jankae/Teststand/Software/Teststand/Teststand.txt

Configuration	Teststand
STM32CubeMX 	4.23.0
Date	01/25/2019
MCU	STM32F103VETx

PERIPHERALS	MODES	FUNCTIONS	PINS
ADC1	IN10	ADC1_IN10	PC0
ADC1	IN11	ADC1_IN11	PC1
CAN	Master	CAN_RX	PB8
CAN	Master	CAN_TX	PB9
I2C2	I2C	I2C2_SCL	PB10
I2C2	I2C	I2C2_SDA	PB11
SPI1	Full-Duplex Master	SPI1_MISO	PA6
SPI1	Full-Duplex Master	SPI1_MOSI	PA7
SPI1	Full-Duplex Master	SPI1_SCK	PA5
SPI2	Full-Duplex Master	SPI2_MISO	PB14
SPI2	Full-Duplex Master	SPI2_MOSI	PB15
SPI2	Full-Duplex Master	SPI2_SCK	PB13
SYS	Serial Wire	SYS_JTCK-SWCLK	PA14
SYS	Serial Wire	SYS_JTMS-SWDIO	PA13
SYS	TIM7	SYS_VS_tim7	VP_SYS_VS_tim7
USART1	Single Wire (Half-Duplex)	USART1_TX	PA9
USART2	Asynchronous	USART2_RX	PA3
USART2	Asynchronous	USART2_TX	PA2
USB	Device (FS)	USB_DM	PA11
USB	Device (FS)	USB_DP	PA12

Pin Nb	PINs	FUNCTIONs	LABELs
15	PC0	ADC1_IN10	
16	PC1	ADC1_IN11	
25	PA2	USART2_TX	
26	PA3	USART2_RX	
30	PA5	SPI1_SCK	
31	PA6	SPI1_MISO	
32	PA7	SPI1_MOSI	
37	PB2	GPIO_Output	PPM
47	PB10	I2C2_SCL	
48	PB11	I2C2_SDA	
51	PB12	GPIO_Output	SPI2_NSS
52	PB13	SPI2_SCK	
53	PB14	SPI2_MISO	
54	PB15	SPI2_MOSI	
55	PD8	GPIO_Output	
56	PD9	GPIO_Output	
57	PD10	GPIO_Output	
58	PD11	GPIO_Output	
59	PD12	GPIO_Output	
60	PD13	GPIO_Output	
61	PD14	GPIO_Output	
62	PD15	GPIO_Output	
63	PC6	GPIO_Output	SD_CS
64	PC7	GPIO_Input	TOUCH_IRQ
65	PC8	GPIO_Input	TOUCH_BUSY
66	PC9	GPIO_Output	TOUCH_CS
68	PA9	USART1_TX	
70	PA11	USB_DM	
71	PA12	USB_DP	
72	PA13	SYS_JTMS-SWDIO	
76	PA14	SYS_JTCK-SWCLK	
78	PC10	GPIO_Output	DISPLAY_RD
79	PC11	GPIO_Output	DISPLAY_WR
80	PC12	GPIO_Output	DISPLAY_RS
81	PD0	GPIO_Output	
82	PD1	GPIO_Output	
83	PD2	GPIO_Output	
84	PD3	GPIO_Output	
85	PD4	GPIO_Output	
86	PD5	GPIO_Output	
87	PD6	GPIO_Output	
88	PD7	GPIO_Output	
95	PB8	CAN_RX	
96	PB9	CAN_TX	

SOFTWARE PROJECT

Project Settings : 
Project Name : Teststand
Project Folder : /home/jan/Projekte/Teststand/Software/Teststand
Toolchain / IDE : Makefile
Firmware Package Name and Version : STM32Cube FW_F1 V1.6.1

Code Generation Settings : 
STM32Cube Firmware Library Package : Copy only the necessary library files
Generate peripheral initialization as a pair of '.c/.h' files per peripheral : No
Backup previously generated files when re-generating : No
Delete previously generated files when not re-generated : Yes
Set all free pins as analog (to optimize the power consumption) : Yes

Toolchains Settings : 
Compiler Optimizations : Balanced Size/Speed
