jankae/Teststand/Hardware/art.bmp

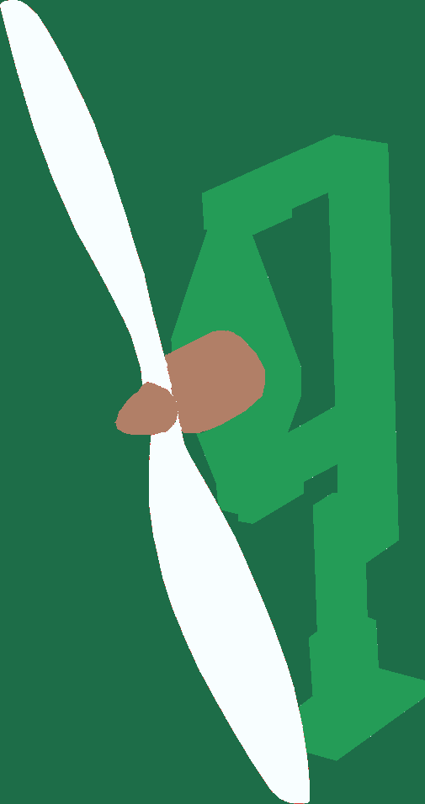
Hardware/art.bmp
