jankae/Teststand/Hardware/Teststand.ods

Qty | Value | Device | Package | Parts | Description | Link
3 |  | 4MMJACK | 4MMJACK | V+, V-_IN, V-_OUT |  | 845-973582100 (https://www.mouser.de/ProductDetail/845-973582100)
1 |  | PINHD-1X2 | 1X02 | DBG | PIN HEADER
4 |  | PINHD-1X3/90 | 1X03/90 | CAN, I2C, PPM, UART | PIN HEADER
1 |  | PINHD-1X4 | 1X04 | SWD | PIN HEADER
1 |  | PINHD-1X5/90 | 1X05/90 | SPI | PIN HEADER
21 | 100 | R-EU_R0603 | R0603 | R3, R4, R5, R6, R7, R8, R9, R10, R11, R12, R13, R14, R17, R18, R19, R20, R21, R22, R23, R24, R25 | RESISTOR, European symbol
3 | 100k | R-EU_R0603 | R0603 | R34, R35, R41 | RESISTOR, European symbol
7 | 100n | C-EUC0603K | C0603K | C3, C4, C5, C6, C7, C11, C12 | CAPACITOR, European symbol
1 | 10k | R-EU_R0603 | R0603 | R36 | RESISTOR, European symbol
4 | 10n | C-EUC0603K | C0603K | C10, C24, C25, C27 | CAPACITOR, European symbol
2 | 10u | C-EUC1206 | C1206 | C17, C20 | CAPACITOR, European symbol
1 | 120 | R-EU_R0603 | R0603 | R16 | RESISTOR, European symbol
2 | 1k | R-EU_R0603 | R0603 | R31, R32 | RESISTOR, European symbol
2 | 1n | C-EUC0603K | C0603K | C2, C22 | CAPACITOR, European symbol
4 | 1u | C-EUC0603K | C0603K | C8, C9, C23, C26 | CAPACITOR, European symbol
1 | 1u | C-EUC1206 | C1206 | C21 | CAPACITOR, European symbol
2 | 22 | R-EU_R0603 | R0603 | R2, R15 | RESISTOR, European symbol
1 | 220n | C-EUC0603K | C0603K | C1 | CAPACITOR, European symbol | EMK107B7224KA-T (https://www.mouser.de/ProductDetail/Taiyo-Yuden/EMK107B7224KA-T)
1 | 27 | R-EU_M1206 | M1206 | R1 | RESISTOR, European symbol
2 | 4k7 | R-EU_R0603 | R0603 | R28, R29 | RESISTOR, European symbol
1 | 51k | R-EU_R0603 | R0603 | R33 | RESISTOR, European symbol | 603-AC0603FR-1051KL (https://www.mouser.de/ProductDetail/603-AC0603FR-1051KL)
3 | 600/0.2A (ferrite) | L-EUL2012C | L2012C | L1, L2, L4 | INDUCTOR, European symbol
1 | AD8538 | AD8519R | SO8 | IC6 | 8 MHz Rail-to-Rail Operational Amplifiers | 584-AD8538ARZ (https://www.mouser.de/ProductDetail/584-AD8538ARZ)
1 | D-SUB25-H3M25RA | D-SUB25-H3M25RA | H3M25RA | X1 | D-Subminiatur Connector | 649-D25S33E4PA00LF (https://www.mouser.de/ProductDetail/649-D25S33E4PA00LF)
1 | KELVIN_RC | KELVIN_RC | CST0612 | R30 |  | 652-CST0612-FC-R001E (https://www.mouser.de/ProductDetail/652-CST0612-FC-R001E)
1 | MAX11254 | MAX11254 | TQFP32-EP | IC2 |  | 700-MAX11254ATJ+ (https://www.mouser.de/ProductDetail/700-MAX11254ATJ%2B)
1 | MCP1700T33 | MCP1703CB | SOT23 | IC5 | 250 mA, 16V, Low Quiescent Current LDO Regulator | 579-MCP1700T3302E/TT (https://www.mouser.de/ProductDetail/579-MCP1700T3302E-TT)
1 | MCP2558 | MCP2558 | SOIC8 | IC3 |  | 579-MCP2558FDT-H/SN (https://www.mouser.de/ProductDetail/579-MCP2558FDT-H-SN)
1 | MINI-USB_SHIELD4P-85-32004-10X | MINI-USB_SHIELD4P-85-32004-10X | 85-32004-10X | X3 | MINI USB 4 Pol.
1 | SAINSMART_TFT_3.2 | SAINSMART_TFT_3.2 | SAINSMART_TFT_3.2 | DISPLAY1
1 | STM32F103VET | STM32F103VET | LQFP100 | IC1 | ARM 32-bit Cortex™-M3 CPU
