jankae/Teststand/Hardware/Teststand.brd

## EAGLE design Hardware/Teststand.brd (2019-01-25)

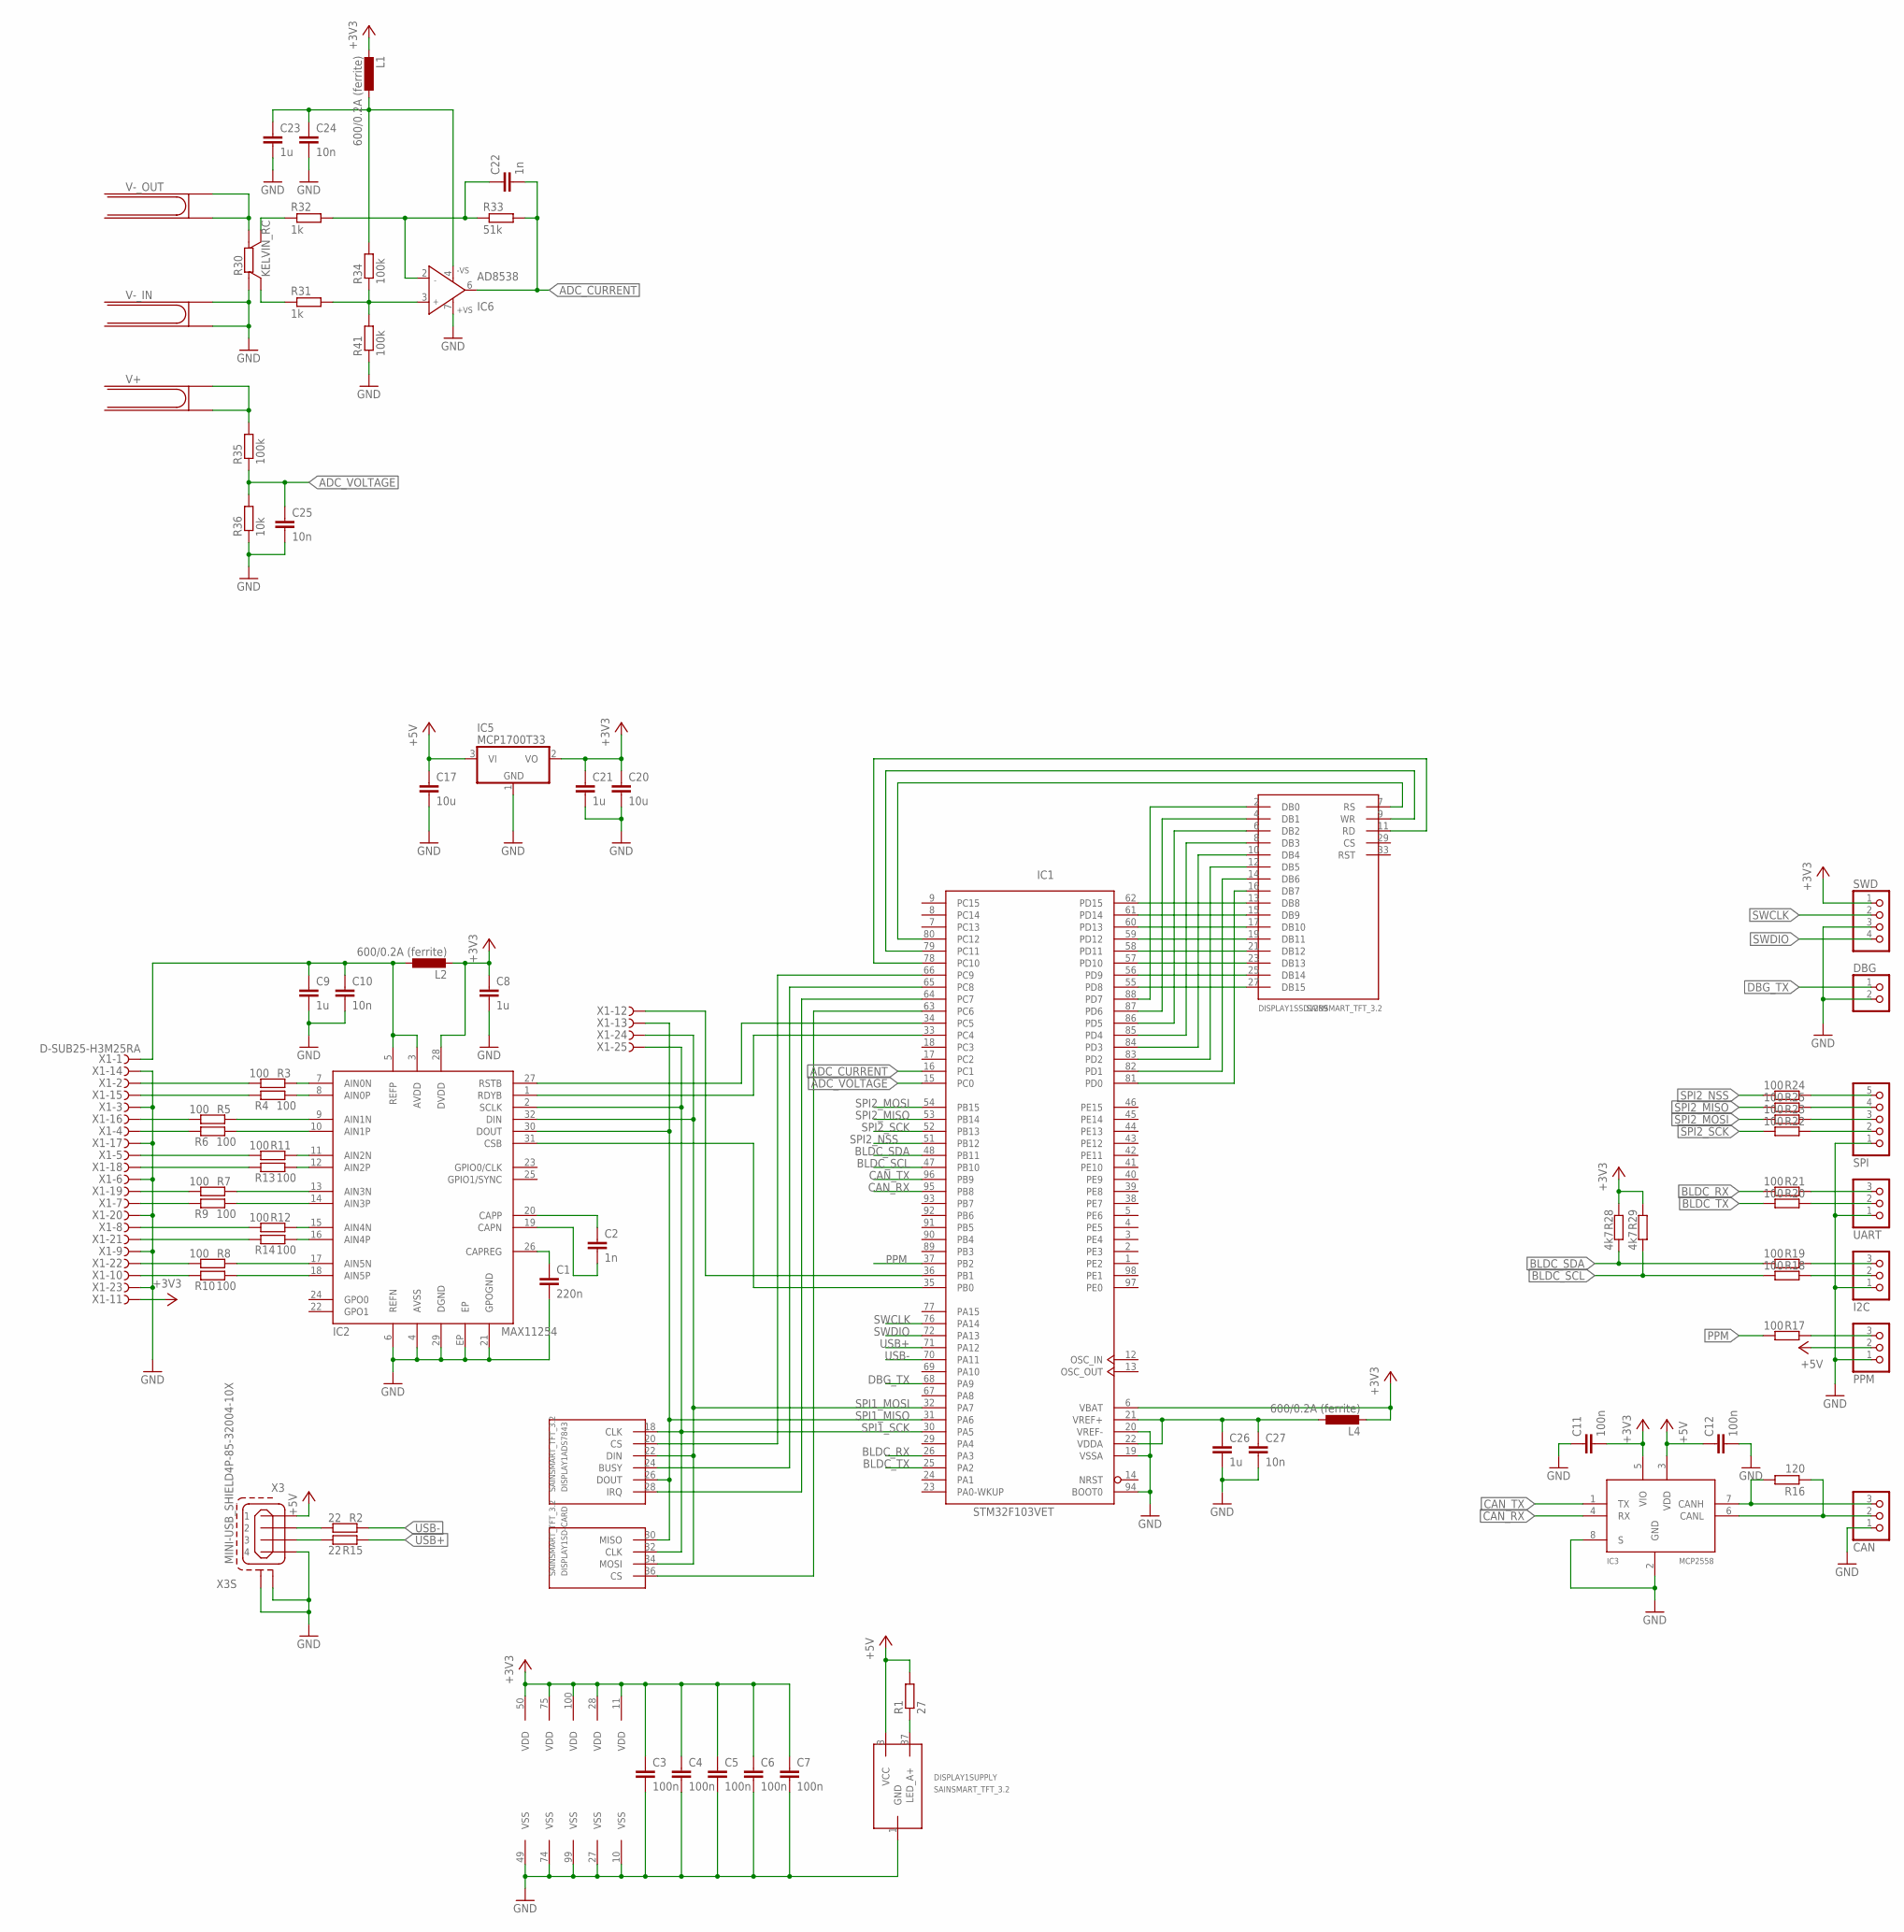
[picture p4: schematic Teststand.sch]

Parts:
C1: 220n; C0603K
C2, C22: 1n; C0603K
C3, C4, C5, C6, C7, C11, C12: 100n; C0603K
C8, C9, C23, C26: 1u; C0603K
C10, C24, C25, C27: 10n; C0603K
C17, C20: 10u; C1206
C21: 1u; C1206
CAN: PINHD-1X3/90; 1X03/90
DBG: PINHD-1X2; 1X02
DISPLAY1: SAINSMART_TFT_3.2
I2C: PINHD-1X3/90; 1X03/90
IC1: STM32F103VET; LQFP100
IC2: MAX11254; TQFP32-EP
IC3: MCP2558; SOIC8
IC5: MCP1700T33; SOT23
IC6: AD8538; SO8
L1, L2, L4: 600/0.2A (ferrite); L2012C
PPM: PINHD-1X3/90; 1X03/90
R1: 27; M1206
R2, R15: 22; R0603
R3, R4, R5, R6, R7, R8, R9, R10, R11, R12, R13, R14, R17, R18, R19, R20, R21, R22, R23, R24, R25: 100; R0603
R16: 120; R0603
R28, R29: 4k7; R0603
R30: KELVIN_RC; CST0612
R31, R32: 1k; R0603
R33: 51k; R0603
R34, R35, R41: 100k; R0603
R36: 10k; R0603
SPI: PINHD-1X5/90; 1X05/90
SWD: PINHD-1X4; 1X04
UART: PINHD-1X3/90; 1X03/90
V+: 4MMJACK
V-_IN: 4MMJACK
V-_OUT: 4MMJACK
X1: D-SUB25-H3M25RA; H3M25RA
X3: MINI-USB_SHIELD4P-85-32004-10X; 85-32004-10X

Connections:
+3V3: C3.1, C4.1, C5.1, C6.1, C7.1, C8.1, C11.2, C20.1, C21.1, IC1.6 (VBAT), IC1.11 (VDD), IC1.28 (VDD), IC1.50 (VDD), IC1.75 (VDD), IC1.100 (VDD), IC2.28 (DVDD), IC3.5 (VIO), IC5.2 (VO), L1.2, L2.2, L4.2, R28.1, R29.1, SWD.1, X1.11
+5V: C12.1, C17.1, DISPLAY1.3 (VCC), IC3.3 (VDD), IC5.3 (VI), PPM.2, R1.2, X3.1
ADC_CURRENT: C22.2, IC1.16 (PC1), IC6.6 (OUT), R33.2
ADC_VOLTAGE: C25.1, IC1.15 (PC0), R35.1, R36.2
BLDC_RX: IC1.26 (PA3), R21.2
BLDC_SCL: IC1.47 (PB10), R18.2, R29.2
BLDC_SDA: IC1.48 (PB11), R19.2, R28.2
BLDC_TX: IC1.25 (PA2), R20.2
CAN_RX: IC1.95 (PB8), IC3.4 (RX)
CAN_TX: IC1.96 (PB9), IC3.1 (TX)
DBG_TX: DBG.1, IC1.68 (PA9)
GND: C1.2, C3.2, C4.2, C5.2, C6.2, C7.2, C8.2, C9.2, C10.2, C11.1, C12.2, C17.2, C20.2, C21.2, C23.2, C24.2, C25.2, C26.2, C27.2, CAN.1, DBG.2, DISPLAY1.1 (GND), I2C.1, IC1.10 (VSS), IC1.19 (VSSA), IC1.20 (VREF-), IC1.27 (VSS), IC1.49 (VSS), IC1.74 (VSS), IC1.94 (BOOT0), IC1.99 (VSS), IC2.4 (AVSS), IC2.6 (REFN), IC2.21 (GPOGND), IC2.29 (DGND), IC2.EP, IC3.2 (GND), IC3.8 (S), IC5.1 (GND), IC6.7 (+VS), PPM.1, R30.B, R36.1, R41.1, SPI.1, SWD.3, UART.1, V-_IN.1@1 (1), V-_IN.1@2 (2), X1.3, X1.6, X1.9, X1.14, X1.17, X1.20, X1.23, X3.4, X3.M1 (S1), X3.M2 (S2)
unnamed: DISPLAY1.13 (DB8), IC1.62 (PD15)
unnamed: DISPLAY1.15 (DB9), IC1.61 (PD14)
unnamed: DISPLAY1.17 (DB10), IC1.60 (PD13)
unnamed: DISPLAY1.19 (DB11), IC1.59 (PD12)
unnamed: DISPLAY1.21 (DB12), IC1.58 (PD11)
unnamed: DISPLAY1.23 (DB13), IC1.57 (PD10)
unnamed: DISPLAY1.25 (DB14), IC1.56 (PD9)
unnamed: DISPLAY1.27 (DB15), IC1.55 (PD8)
unnamed: DISPLAY1.2 (DB0), IC1.88 (PD7)
unnamed: DISPLAY1.4 (DB1), IC1.87 (PD6)
unnamed: DISPLAY1.6 (DB2), IC1.86 (PD5)
unnamed: DISPLAY1.8 (DB3), IC1.85 (PD4)
unnamed: DISPLAY1.10 (DB4), IC1.84 (PD3)
unnamed: DISPLAY1.12 (DB5), IC1.83 (PD2)
unnamed: DISPLAY1.14 (DB6), IC1.82 (PD1)
unnamed: DISPLAY1.16 (DB7), IC1.81 (PD0)
unnamed: DISPLAY1.7 (RS), IC1.80 (PC12)
unnamed: DISPLAY1.9 (WR), IC1.79 (PC11)
unnamed: DISPLAY1.11 (RD), IC1.78 (PC10)
unnamed: DISPLAY1.20 (CS), IC1.66 (PC9)
unnamed: DISPLAY1.24 (BUSY), IC1.65 (PC8)
unnamed: C1.1, IC2.26 (CAPREG)
unnamed: C2.1, IC2.20 (CAPP)
unnamed: C2.2, IC2.19 (CAPN)
unnamed: R3.2, X1.2
unnamed: R4.1, X1.15
unnamed: DISPLAY1.37 (LED_A+), R1.1
unnamed: C9.1, C10.1, IC2.3 (AVDD), IC2.5 (REFP), L2.1, X1.1
unnamed: IC2.9 (AIN1N), R5.1
unnamed: IC2.10 (AIN1P), R6.2
unnamed: R5.2, X1.16
unnamed: R6.1, X1.4
unnamed: IC2.13 (AIN3N), R7.1
unnamed: IC2.14 (AIN3P), R9.2
unnamed: R11.2, X1.5
unnamed: R13.1, X1.18
unnamed: IC2.17 (AIN5N), R8.1
unnamed: IC2.18 (AIN5P), R10.2
unnamed: R7.2, X1.19
unnamed: R9.1, X1.7
unnamed: R12.2, X1.8
unnamed: R14.1, X1.21
unnamed: IC2.15 (AIN4N), R12.1
unnamed: IC2.16 (AIN4P), R14.2
unnamed: IC2.12 (AIN2P), R13.2
unnamed: IC2.11 (AIN2N), R11.1
unnamed: R8.2, X1.22
unnamed: R10.1, X1.10
unnamed: IC2.8 (AIN0P), R4.2
unnamed: IC2.7 (AIN0N), R3.1
unnamed: R2.2, X3.2
unnamed: R15.2, X3.3
unnamed: CAN.3, IC3.7 (CANH), R16.2
unnamed: CAN.2, IC3.6 (CANL), R16.1
unnamed: IC1.34 (PC5), IC2.27 (RSTB)
unnamed: R24.1, SPI.5
unnamed: R25.1, SPI.4
unnamed: R23.1, SPI.3
unnamed: R22.1, SPI.2
unnamed: R21.1, UART.3
unnamed: R20.1, UART.2
unnamed: I2C.3, R19.1
unnamed: I2C.2, R18.1
unnamed: PPM.3, R17.1
unnamed: IC1.33 (PC4), IC2.1 (RDYB)
unnamed: IC1.35 (PB0), IC2.31 (CSB)
unnamed: DISPLAY1.28 (IRQ), IC1.64 (PC7)
unnamed: DISPLAY1.36 (CS), IC1.63 (PC6)
unnamed: IC1.36 (PB1), X1.12
unnamed: R35.2, V+.1@1 (1), V+.1@2 (2)
unnamed: R30.A, V-_OUT.1@1 (1), V-_OUT.1@2 (2)
unnamed: C26.1, C27.1, IC1.21 (VREF+), IC1.22 (VDDA), L4.1
unnamed: C23.1, C24.1, IC6.4 (-VS), L1.1, R34.2
unnamed: R30.SA, R32.1
unnamed: C22.1, IC6.2 (IN-), R32.2, R33.1
unnamed: R30.SB, R31.1
unnamed: IC6.3 (IN+), R31.2, R34.1, R41.2
PPM: IC1.37 (PB2), R17.2
SPI1_MISO: DISPLAY1.26 (DOUT), DISPLAY1.30 (MISO), IC1.31 (PA6), IC2.30 (DOUT), X1.13
SPI1_MOSI: DISPLAY1.22 (DIN), DISPLAY1.34 (MOSI), IC1.32 (PA7), IC2.32 (DIN), X1.24
SPI1_SCK: DISPLAY1.18 (CLK), DISPLAY1.32 (CLK), IC1.30 (PA5), IC2.2 (SCLK), X1.25
SPI2_MISO: IC1.53 (PB14), R25.2
SPI2_MOSI: IC1.54 (PB15), R23.2
SPI2_NSS: IC1.51 (PB12), R24.2
SPI2_SCK: IC1.52 (PB13), R22.2
SWCLK: IC1.76 (PA14), SWD.2
SWDIO: IC1.72 (PA13), SWD.4
USB+: IC1.71 (PA12), R15.1
USB-: IC1.70 (PA11), R2.1

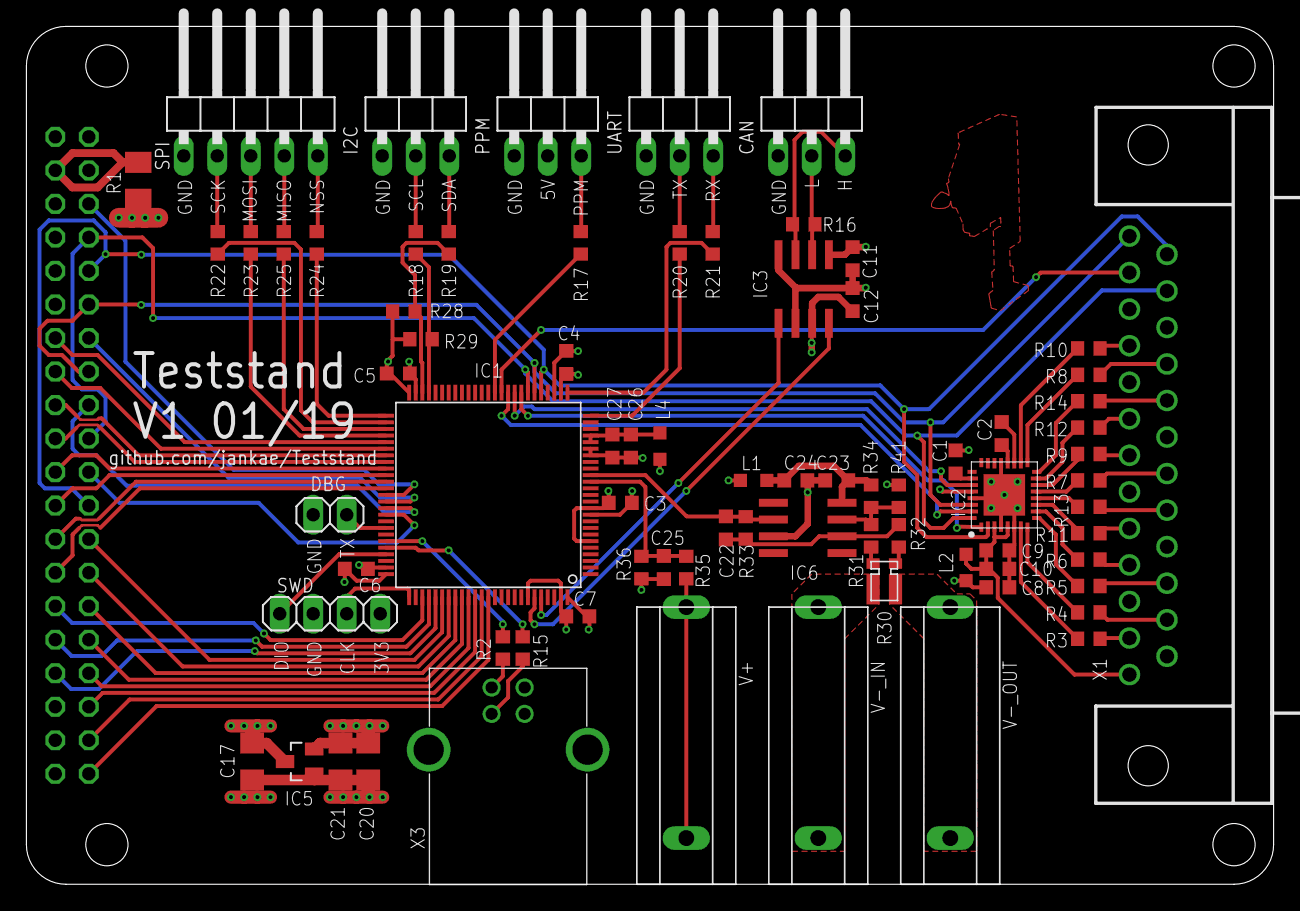
[picture p5: board Teststand.brd from above]

Board: 4 copper layers, 94.5 x 65.0 mm, 77 parts (1 on the bottom side), 101 nets.
