jankae/Teststand/Software/Teststand/Teststand.ioc

Mcu.UserName=STM32F103VETx
PA10.Signal=USART1_RX
PA11.Signal=USB_DM
PA12.Signal=USB_DP
PA13.Signal=SYS_JTMS-SWDIO
PA14.Signal=SYS_JTCK-SWCLK
PA2.Signal=USART2_TX
PA3.Signal=USART2_RX
PA5.Signal=SPI1_SCK
PA6.Signal=SPI1_MISO
PA7.Signal=SPI1_MOSI
PA9.Signal=USART1_TX
PB10.Signal=I2C2_SCL
PB11.Signal=I2C2_SDA
PB12.GPIO_Label=SPI2_NSS
PB12.Signal=GPIO_Output
PB13.Signal=SPI2_SCK
PB14.Signal=SPI2_MISO
PB15.Signal=SPI2_MOSI
PB2.GPIO_Label=PPM
PB2.Signal=GPIO_Output
PB8.Signal=CAN_RX
PB9.Signal=CAN_TX
PC0.Signal=ADCx_IN10
PC1.Signal=ADCx_IN11
PC10.GPIO_Label=DISPLAY_RD
PC10.Signal=GPIO_Output
PC11.GPIO_Label=DISPLAY_WR
PC11.Signal=GPIO_Output
PC12.GPIO_Label=DISPLAY_RS
PC12.Signal=GPIO_Output
PC5.GPIO_Label=MAX11254_RESET
PC5.Signal=GPIO_Output
PC6.GPIO_Label=SD_CS
PC6.Signal=GPIO_Output
PC7.GPIO_Label=TOUCH_IRQ
PC7.Signal=GPIO_Input
PC8.GPIO_Label=TOUCH_BUSY
PC8.Signal=GPIO_Input
PC9.GPIO_Label=TOUCH_CS
PC9.Signal=GPIO_Output
PD0.Signal=GPIO_Output
PD1.Signal=GPIO_Output
PD10.Signal=GPIO_Output
PD11.Signal=GPIO_Output
PD12.Signal=GPIO_Output
PD13.Signal=GPIO_Output
PD14.Signal=GPIO_Output
PD15.Signal=GPIO_Output
PD2.Signal=GPIO_Output
PD3.Signal=GPIO_Output
PD4.Signal=GPIO_Output
PD5.Signal=GPIO_Output
PD6.Signal=GPIO_Output
PD7.Signal=GPIO_Output
PD8.Signal=GPIO_Output
PD9.Signal=GPIO_Output
PE13.GPIO_Label=DISPLAY_CS
PE13.Signal=GPIO_Output
PE8.GPIO_Label=DISPLAY_RST
PE8.Signal=GPIO_Output
