jankae/Teststand/Software/Teststand/Application/Setup.hpp

#pragma once

#include "display.h"

namespace Setup {

static const uint16_t imagedata[1024] = {
	0x0000,0x0000,0x0000,0x0000,0x4228,0x8cd2,0x94f3,0x7c30,0x39e7,0x0000,0x0000,0x0000,0x0000,0x0000,0x0000,0x0000,0x0000,0x0000,0x0000,0x0000,0x0000,0x0000,0x0000,0x0000,0x0000,0x0000,0x0000,0x18c3,0x7c10,0x73ef,0x0020,0x0000,
	0x0000,0x0000,0x0000,0x0000,0x0841,0x8cb2,0xdf5c,0xe7be,0xceba,0x9513,0x4a8a,0x0000,0x0000,0x0000,0x0000,0x0000,0x0000,0x0000,0x0000,0x0000,0x0000,0x0000,0x0000,0x0000,0x0000,0x0000,0x52cb,0x9d34,0xdf5c,0xd71c,0x73ef,0x0041,
	0x0000,0x0000,0x0000,0x0000,0x0000,0x0841,0x7c50,0xbe58,0xc6ba,0xdf5d,0xbe58,0x632c,0x0000,0x0000,0x0000,0x0000,0x0000,0x0000,0x0000,0x0000,0x0000,0x0000,0x0000,0x0000,0x0000,0x52eb,0xbe59,0xd73c,0xd73c,0xd71c,0x9d14,0x10a2,
	0x0000,0x634d,0x2945,0x0000,0x0000,0x0000,0x0841,0x8451,0xc679,0xc679,0xcedb,0x9d34,0x0000,0x0000,0x0000,0x0000,0x0000,0x0000,0x0000,0x0000,0x0000,0x0000,0x0000,0x0000,0x0861,0x7c30,0xd75c,0xd73c,0xd73c,0xbe59,0x4a8a,0x0000,
	0x0000,0x9514,0x9d34,0x2124,0x0000,0x0000,0x0000,0x52ca,0xb618,0xbe79,0xbe79,0xa575,0x0000,0x0000,0x0000,0x0000,0x0000,0x0000,0x0000,0x0000,0x0000,0x0000,0x0000,0x1082,0x6b8e,0xe79e,0xe79e,0xd75c,0xd71c,0x73cf,0x0000,0x0000,
	0x0000,0x8cb2,0xd73c,0x9d34,0x18c3,0x0000,0x18e3,0x8cd3,0xc6ba,0xbe79,0xbe79,0x9d34,0x0000,0x0000,0x0000,0x0000,0x0000,0x0000,0x0000,0x0000,0x0000,0x0000,0x1082,0x4a8a,0xe79e,0xe79e,0xe79e,0x9514,0x6bcf,0x1082,0x0000,0x0000,
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
};


static constexpr Image_t Icon = {.width = 32, .height = 32, .data = imagedata};

void Task(void *a);

}
