jankae/Teststand/(commit log)

2018-12-13 Partial schematic + layout
    [Teststand.brd, Teststand.sch]
2019-01-25 MAX11254, display and touch driver + basic selftest
2019-01-25 BOM, Gerber + PCB art
    [Teststand.brd, Teststand.ods, Teststand.sch]
2019-01-25 Description of PCB errors
2019-01-27 GUI adapted to purely touch based device
2019-01-28 FatFs support + loadcell driver
2019-01-30 Loadcell calibration + value input dialog
2019-02-05 Touch calibration read/write, loadcell settigns improved
2019-02-06 Partial PPM motor driver
2019-02-07 Partial motor driver app + GUI improvements (better callbacks + radiobuttons)
2019-02-08 Slider added to driver control
2019-02-10 PPM driver completed, bugfix partial string display
    [DriverControl.cpp, PPMDriver.cpp, PPMDriver.hpp, Unit.cpp, dialog.cpp, display.c, entry.cpp, entry.hpp]
2019-02-10 Bugfix touch input while switching apps
    [DriverControl.cpp, container.cpp, desktop.cpp, widget.cpp]
2019-02-10 BLCtrl driver stubs + support for Hex input
2019-02-10 I2C function support for BL-Ctrl
2019-02-18 Readback and display of motor driver data
2019-06-18 Combining loadcells to torque/thrust, preparations for ramp, general bugfixes
    [DriverControl.cpp, LoadcellSetup.cpp, Loadcells.cpp, Loadcells.hpp, Setup.cpp, Start.cpp, Unit.cpp, Unit.hpp]
2019-06-18 Drawings top/bottom case
2019-07-10 Store sample rate of loadcells in config
